pfreney/Apple-II-Joystick-and-Paddles-tester/pictures/Back.png

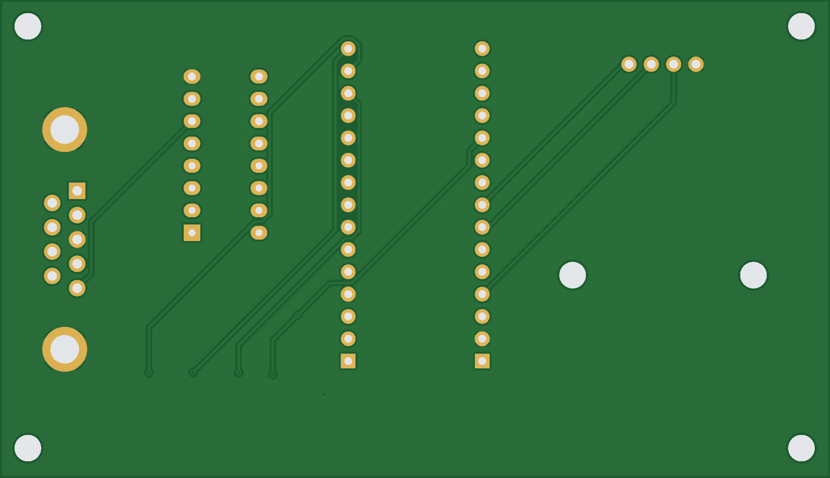
pictures/Back.png
