pfreney/Apple-II-Joystick-and-Paddles-tester/pictures/Front.png

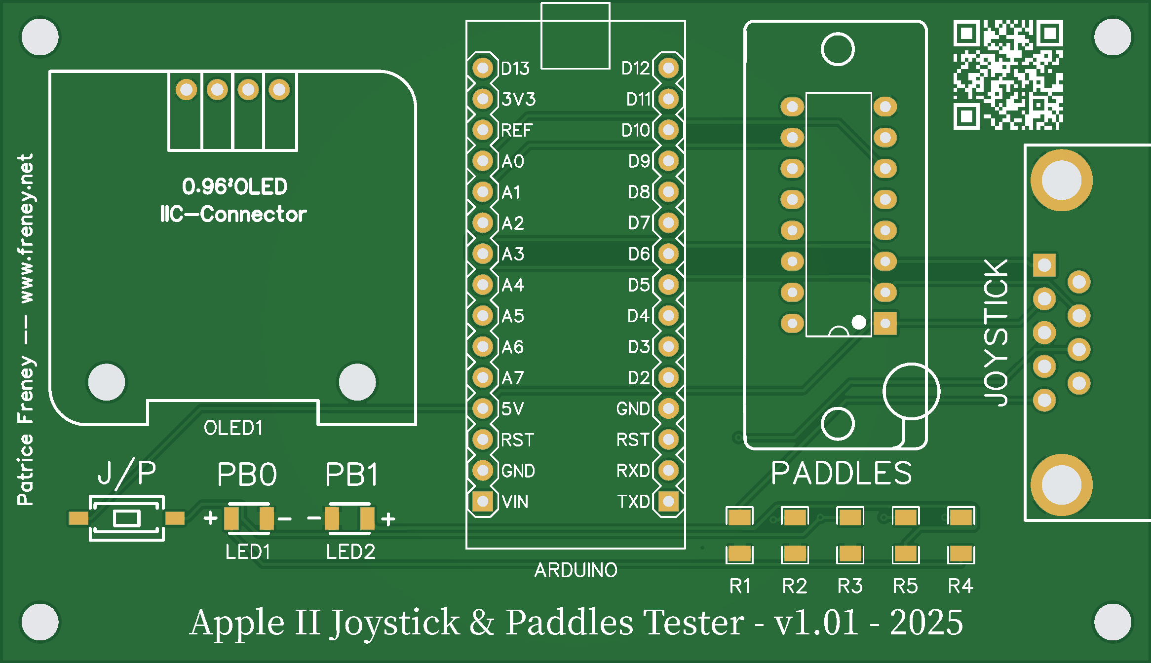
pictures/Front.png
