pfreney/Apple-II-Joystick-and-Paddles-tester/schematics/schematic_apple-ii-game-controllers.pdf

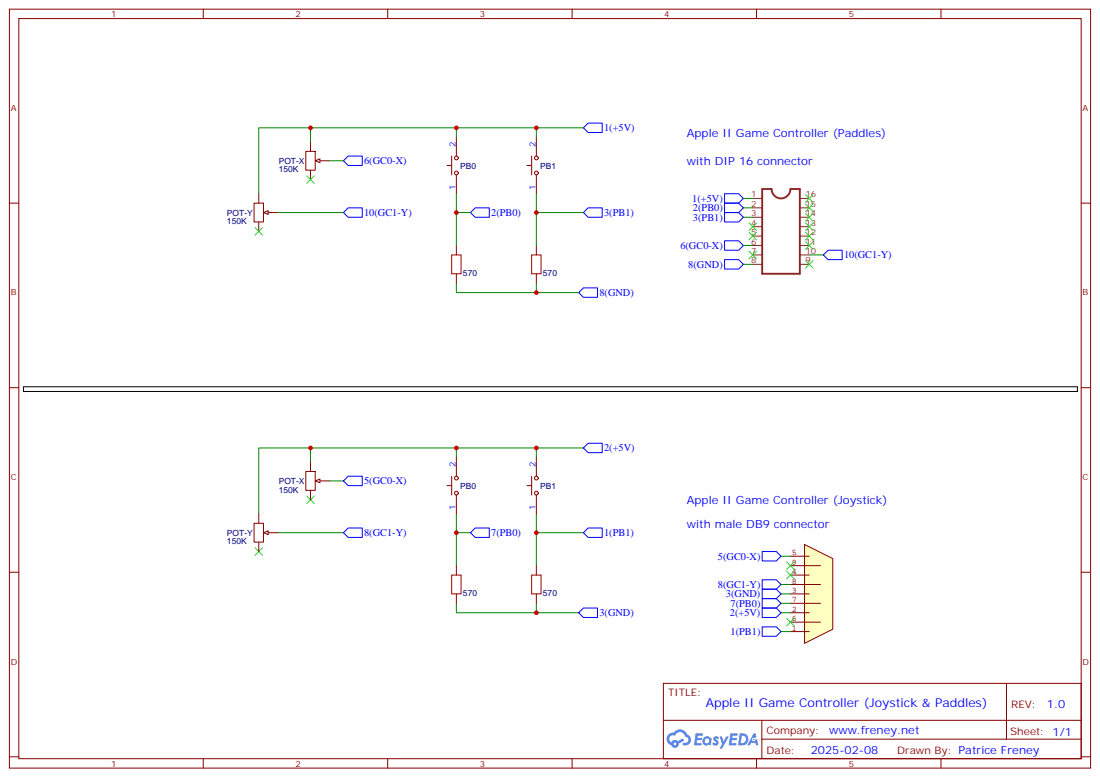
[picture p4: page 1]

Apple II Game Controller (Paddles)

Apple II Game Controller (Joystick)
with male DB9 connector

Company: www.freney.net

Drawn By: Patrice Freney
