pfreney/Apple-II-Joystick-and-Paddles-tester/schematics/Schematic_Apple-Joystick-Tester.pdf

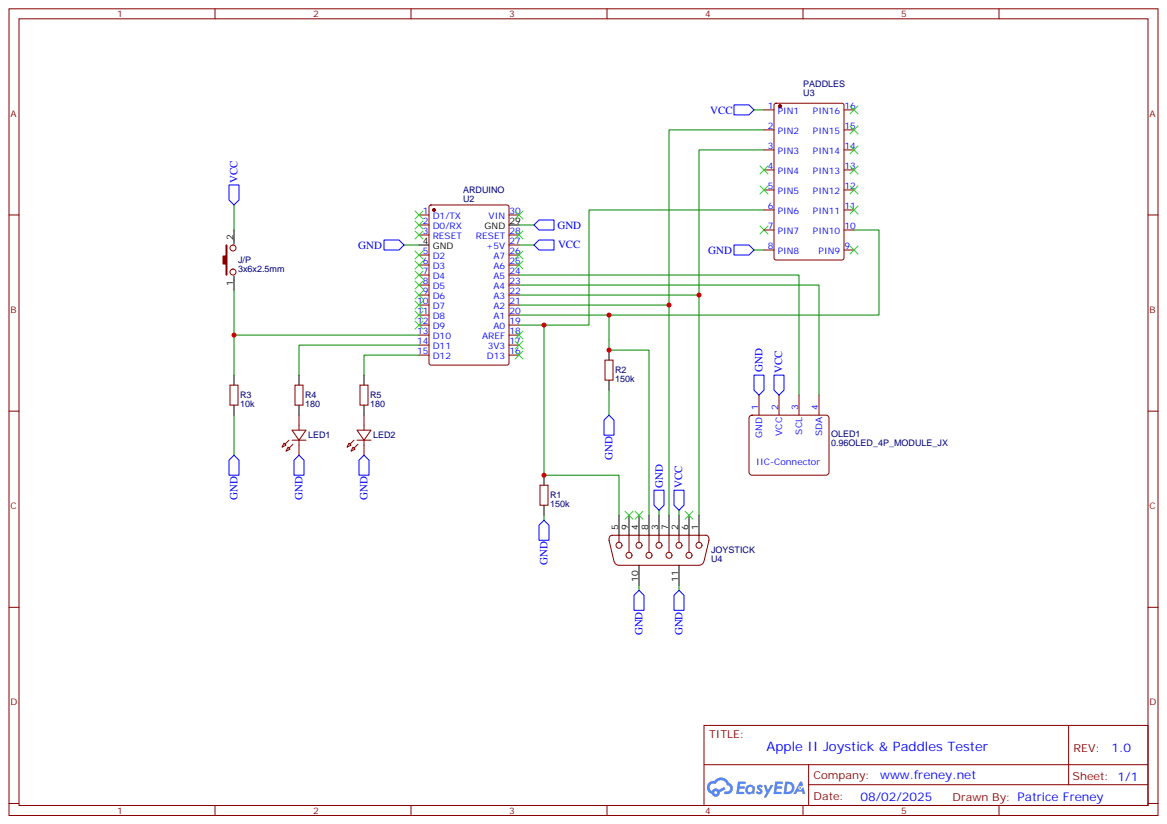
[picture p5: page 1]

Company: www.freney.net

Drawn By: Patrice Freney
