pfreney/Apple-II-Joystick-and-Paddles-tester/(threads)

Thread 2 (2025-03-21):

Button value might read lower than 1000

microbmen, 2025-03-21:
I found a few types of joystick connectors that did seem to trigger Button 0 and Button 1 values.  Upon changing the condition for ve_buttonx_valeur to <900 , voila, it now meets the condition and I get a light.

if (ve_button0_valeur < 1000) {

///\\//\\// SMALL CHANGE

// gestion du bouton 0
  display.setCursor(70, 23);
  display.print("PB0 : ");
  Serial.print(F("Button0: "));
  Serial.print(ve_button0_valeur);
  **if (ve_button0_valeur < 900) {**
    display.print("OFF");
    digitalWrite(led_button_0, LOW);
  } else {
    display.print("ON");
    digitalWrite(led_button_0, HIGH);
  }

  // gestion du bouton 1
  display.setCursor(70, 33);
  display.print("PB1 : ");
  Serial.print(" : Button1: ");
  Serial.print(ve_button1_valeur);
  Serial.println();
  **if (ve_button1_valeur < 900) {**
    display.print("OFF");
    digitalWrite(led_button_1, LOW);
  } else {
    display.print("ON");
    digitalWrite(led_button_1, HIGH);
  }

pfreney, 2025-03-24:
Hello,
Thank you for your message.
Is this for Apple joysticks only or for compatible joysticks?

microbmen, 2025-03-24:
I think any joystick that resists a bit more will show up with a lower value.  An Apple Joystick gave a value of 1010-1020.,  very close to 1000 line.  A Mach II I have gave 980ish.  A modern adapter that converts Atari to Apple gave 980-990. and finally the modern bluetooth adapter GABE gave 980ish.
I'm not sure at what value the Apple itself would register a button press.  Id suspect much lower.  No button press was <50.

pfreney, 2025-03-26:
I tested it with original Apple joystick and some compatible I have, and all were functional.
I didn't know the bluetooth adapter GABE existence. :-)

Indeed, I think I can lower the input value to any value greater than 100.
I didn't want to take any reading risk when I did the first tests. I confess I didn't optimize this value.
500 must be a good compromise without risk.
I've just modified the program on GitHub.
Thanks a lot.

microbmen, 2025-03-26:
I like 500 or 750, it's a safe accurate value.
