pfreney/Apple-II-Joystick-and-Paddles-tester/(commit log)

2025-02-12 Back pcb
2025-02-12 Circuit board and case images
